stefaema/STEF/boards/transport/command_board/command_board.kicad_pcb

## KiCad design boards/transport/command_board/command_board.kicad_pcb (2026-08-15)

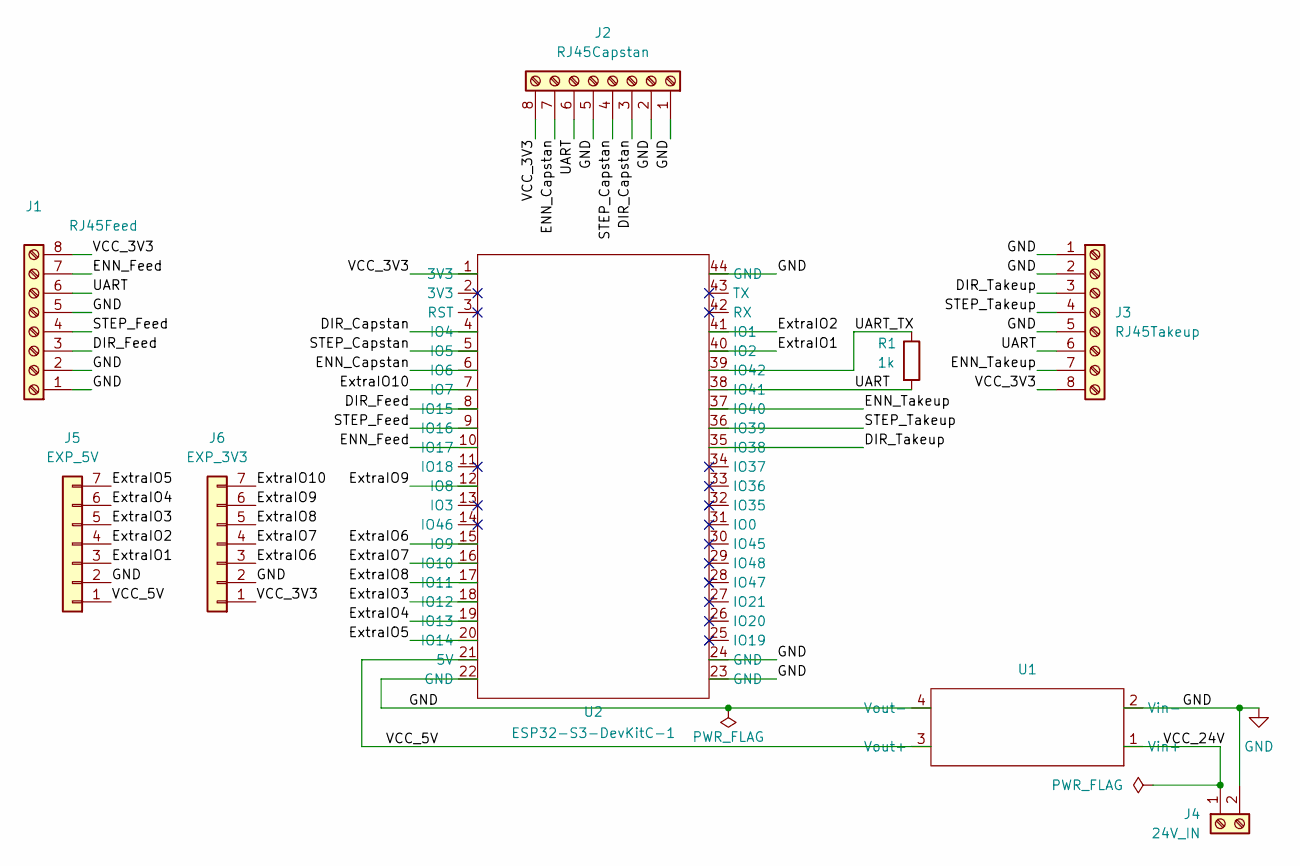
[picture p1: schematic command_board.kicad_sch, STEF Command Board]

Parts:
J1: RJ45Feed; PhoenixContact_MC_1,5_8-G-3.5_1x08_P3.50mm_Horizontal
J2: RJ45Capstan; PhoenixContact_MC_1,5_8-G-3.5_1x08_P3.50mm_Horizontal
J3: RJ45Takeup; PhoenixContact_MC_1,5_8-G-3.5_1x08_P3.50mm_Horizontal
J4: 24V_IN; TerminalBlock_RND_205-00287_1x02_P5.08mm_Horizontal
J5: EXP_5V; PinHeader_1x07_P2.54mm_Vertical
J6: EXP_3V3; PinHeader_1x07_P2.54mm_Vertical
R1: 1k; R_Axial_DIN0207_L6.3mm_D2.5mm_P10.16mm_Horizontal
U1: Buck_LM2596; Buck_LM2596_Socketed_2x02
U2: ESP32-S3-DevKitC-1; ESP32-S3-DevKitC-1_Socketed_2x22

Connections:
/DIR_Capstan: J2.3, U2.4 (IO4)
/DIR_Feed: J1.3, U2.8 (IO15)
/DIR_Takeup: J3.3, U2.35 (IO38)
/ENN_Capstan: J2.7, U2.6 (IO6)
/ENN_Feed: J1.7, U2.10 (IO17)
/ENN_Takeup: J3.7, U2.37 (IO40)
/ExtraIO1: J5.3, U2.40 (IO2)
/ExtraIO2: J5.4, U2.41 (IO1)
/ExtraIO3: J5.5, U2.18 (IO12)
/ExtraIO4: J5.6, U2.19 (IO13)
/ExtraIO5: J5.7, U2.20 (IO14)
/ExtraIO6: J6.3, U2.15 (IO9)
/ExtraIO7: J6.4, U2.16 (IO10)
/ExtraIO8: J6.5, U2.17 (IO11)
/ExtraIO9: J6.6, U2.12 (IO8)
/ExtraIO10: J6.7, U2.7 (IO7)
/STEP_Capstan: J2.4, U2.5 (IO5)
/STEP_Feed: J1.4, U2.9 (IO16)
/STEP_Takeup: J3.4, U2.36 (IO39)
/UART: J1.6, J2.6, J3.6, R1.2, U2.38 (IO41)
/UART_TX: R1.1, U2.39 (IO42)
/VCC_3V3: J1.8, J2.8, J3.8, J6.1, U2.1 (3V3)
/VCC_5V: J5.1, U1.3 (Vout+), U2.21 (5V)
/VCC_24V: J4.1, U1.1 (Vin+)
GND: J1.1, J1.2, J1.5, J2.1, J2.2, J2.5, J3.1, J3.2, J3.5, J4.2, J5.2, J6.2, U1.2 (Vin-), U1.4 (Vout-), U2.22 (GND), U2.23 (GND), U2.24 (GND), U2.44 (GND)

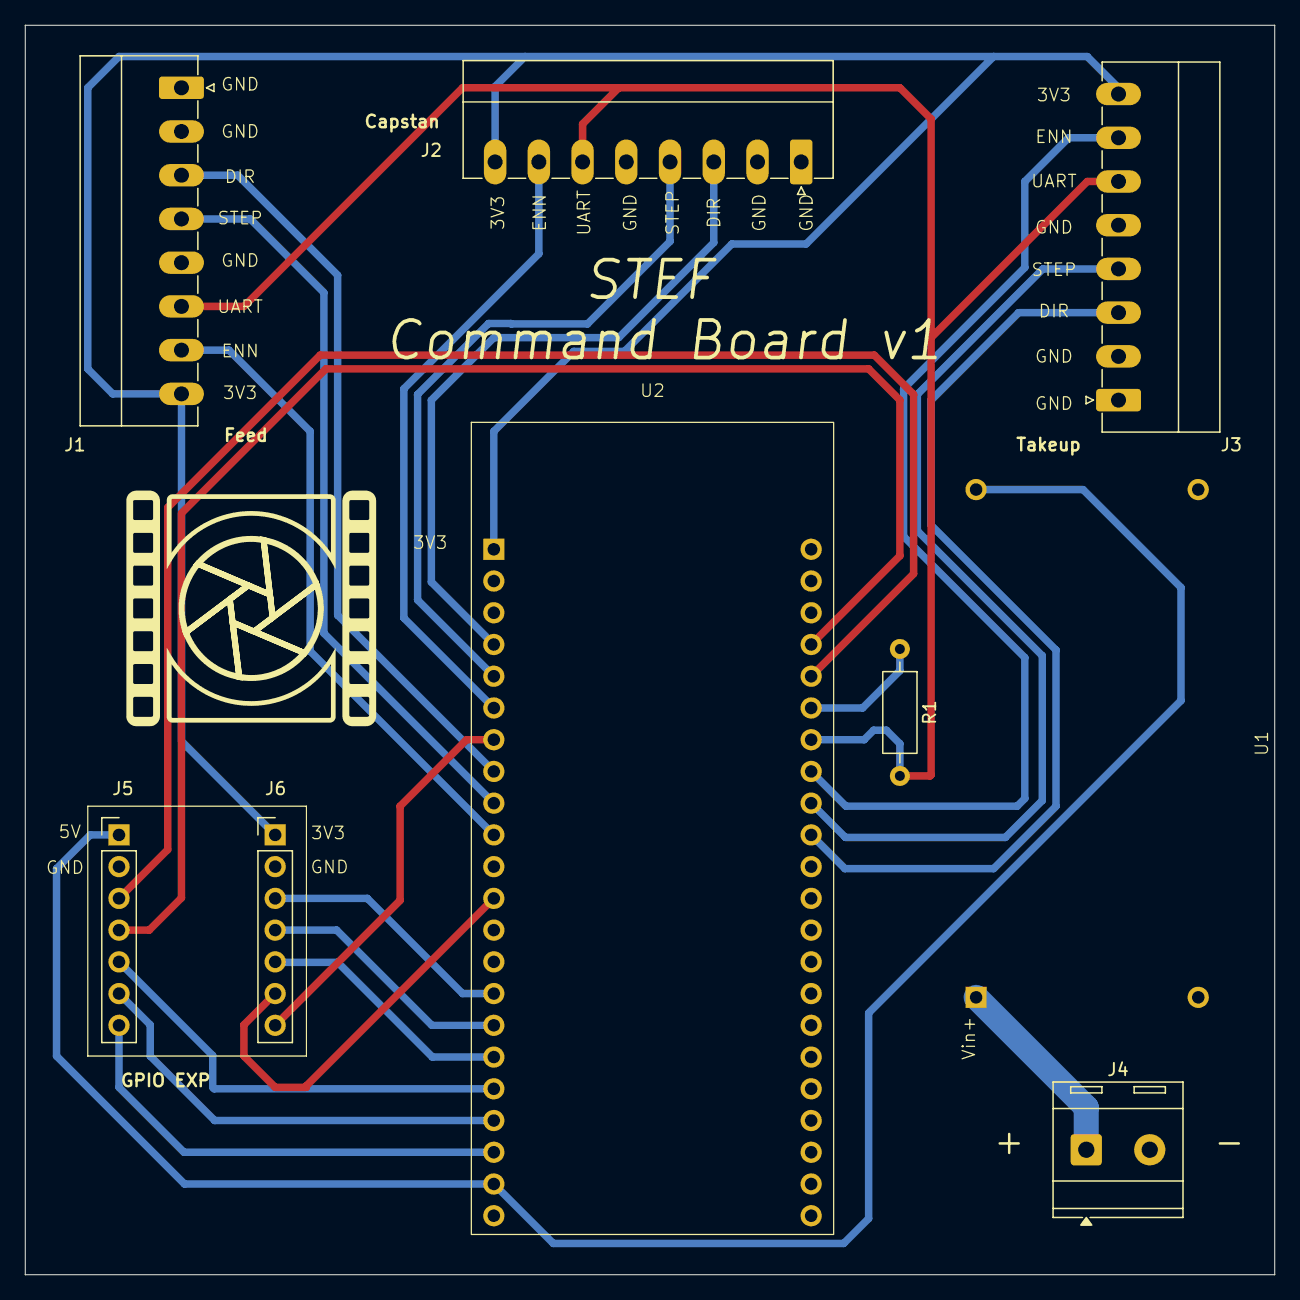
[picture p2: board command_board.kicad_pcb from above]

Board: 2 copper layers, 100.0 x 100.0 mm, 9 parts (0 on the bottom side), 25 nets.
