stefaema/STEF/boards/transport/drive_board/drive_board.kicad_pcb

## KiCad design boards/transport/drive_board/drive_board.kicad_pcb (2026-08-15)

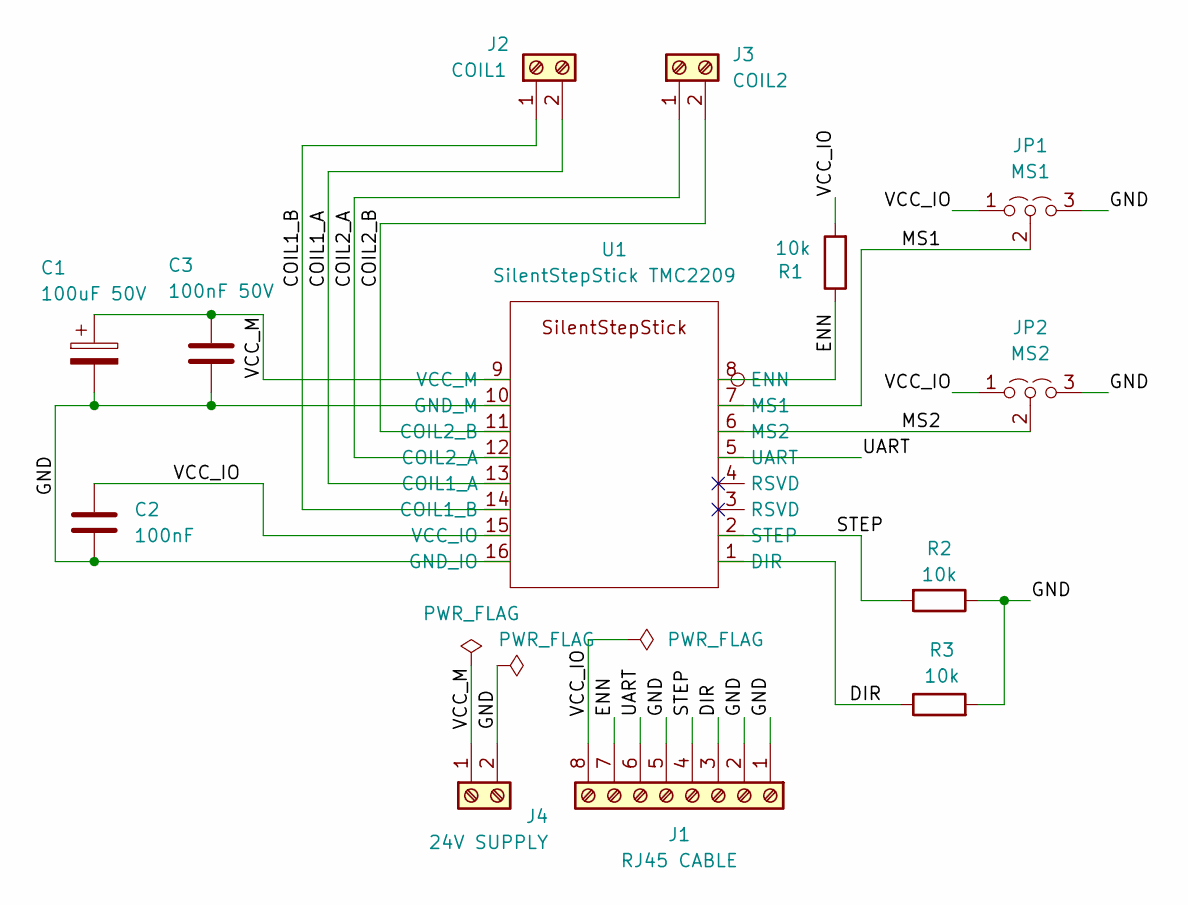
[picture p3: schematic drive_board.kicad_sch, STEF Drive Board]

Parts:
C1: 100uF 50V; CP_Radial_D8.0mm_P5.00mm
C2: 100nF; C_Disc_D7.0mm_W2.5mm_P5.00mm
C3: 100nF 50V; C_Disc_D7.0mm_W2.5mm_P5.00mm
J1: RJ45 CABLE; PhoenixContact_MC_1,5_8-G-3.5_1x08_P3.50mm_Horizontal
J2: COIL1; TerminalBlock_RND_205-00287_1x02_P5.08mm_Horizontal
J3: COIL2; TerminalBlock_RND_205-00287_1x02_P5.08mm_Horizontal
J4: 24V SUPPLY; TerminalBlock_RND_205-00287_1x02_P5.08mm_Horizontal
JP1: MS1; PinHeader_1x03_P2.54mm_Vertical
JP2: MS2; PinHeader_1x03_P2.54mm_Vertical
R1, R2, R3: 10k; R_Axial_DIN0207_L6.3mm_D2.5mm_P10.16mm_Horizontal
U1: SilentStepStick TMC2209; SilentStepStick_Socketed_2x08

Connections:
/COIL1_A: J2.2, U1.13 (COIL1_A)
/COIL1_B: J2.1, U1.14 (COIL1_B)
/COIL2_A: J3.1, U1.12 (COIL2_A)
/COIL2_B: J3.2, U1.11 (COIL2_B)
/DIR: J1.3, R3.1, U1.1 (DIR)
/ENN: J1.7, R1.1, U1.8 (ENN)
/GND: C1.2, C2.2, C3.2, J1.1, J1.2, J1.5, J4.2, JP1.3 (B), JP2.3 (B), R2.1, R3.2, U1.10 (GND_M), U1.16 (GND_IO); also elsewhere on the board
/MS1: JP1.2 (C), U1.7 (MS1); also elsewhere on the board
/MS2: JP2.2 (C), U1.6 (MS2)
/STEP: J1.4, R2.2, U1.2 (STEP)
/UART: J1.6, U1.5 (UART)
/VCC_IO: C2.1, J1.8, JP1.1 (A), JP2.1 (A), R1.2, U1.15 (VCC_IO); also elsewhere on the board
/VCC_M: C1.1, C3.1, J4.1, U1.9 (VCC_M)

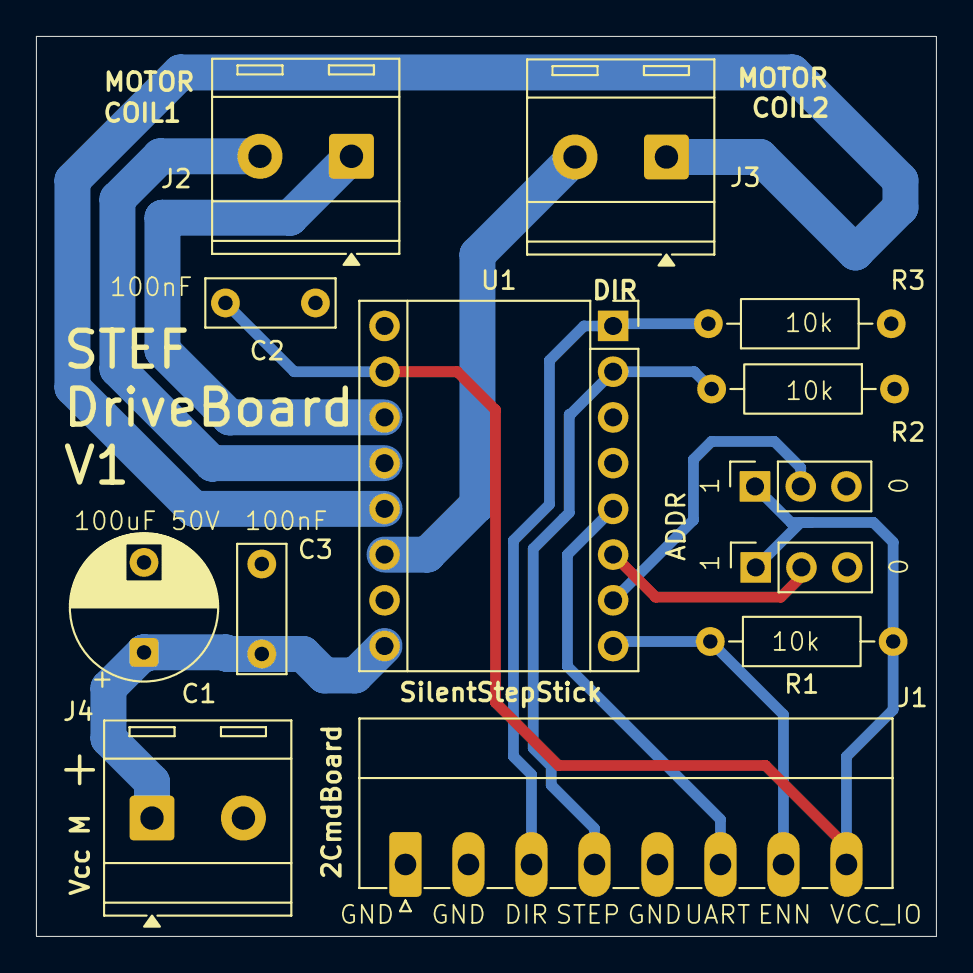
[picture p4: board drive_board.kicad_pcb from above]

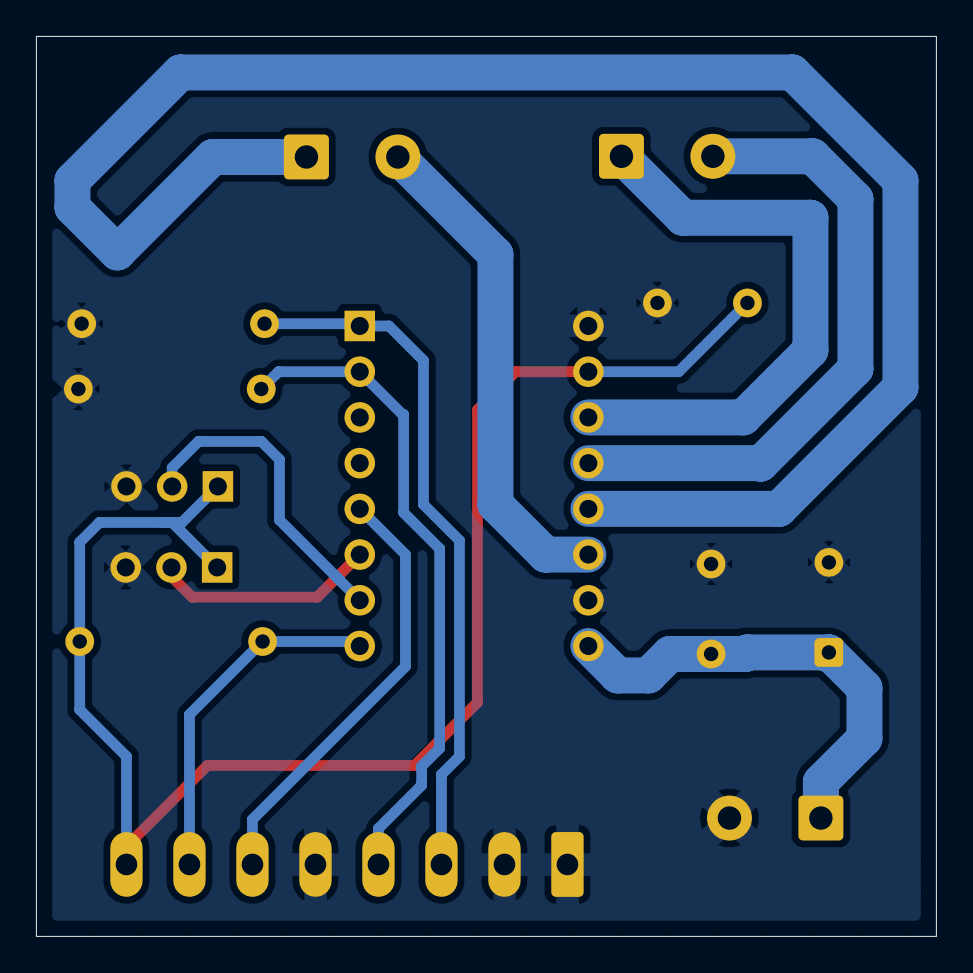
[picture p5: board drive_board.kicad_pcb from below]

Board: 2 copper layers, 50.0 x 50.0 mm, 13 parts (8 on the bottom side), 13 nets.

Other parts of the board:
ADDR: MS1; PinHeader_1x03_P2.54mm_Vertical

Their connections:
/GND: ADDR.3 (B); also elsewhere on the board
/MS1: ADDR.2 (C); also elsewhere on the board
/VCC_IO: ADDR.1 (A); also elsewhere on the board
