stefaema/STEF/portable/tmc2209/test/test_lines.c

/*
 * test_lines.c: the control lines, against a fake board.
 *
 * The theme is that a line call either does exactly what it says or refuses.
 * There is no third outcome where some other pin moves, which is what the
 * wiring mask exists to prevent: a board that does not connect DIAG must be
 * told apart from a board that connects it and reads low.
 *
 * Polarity is the other half. ENN is active low, so enable() and the raw level
 * disagree by construction, and a test that only ever asked one of them could
 * not tell a correct implementation from an inverted one.
 */

#include "tmc2209.h"
#include "unity.h"

#include <string.h>

/* A board with four pins. Levels persist, so a write is observable by the
   read that follows it, the way a real output reads back what it drives. */
typedef struct {
    bool     level[TMC2209_LINE_COUNT];
    unsigned writes[TMC2209_LINE_COUNT];
    unsigned reads[TMC2209_LINE_COUNT];
    int      fail_read;    /* backend failure, until cleared */
    int      fail_write;
} fake_board_t;

static fake_board_t    g_board;
static tmc2209_lines_t g_lines;
static tmc2209_t       g_dev;

static int board_read(void *ctx, tmc2209_line_t line)
{
    fake_board_t *b = (fake_board_t *)ctx;
    b->reads[line]++;
    if (b->fail_read) {
        return -1;
    }
    return (int)b->level[line];
}

static int board_write(void *ctx, tmc2209_line_t line, bool level)
{
    fake_board_t *b = (fake_board_t *)ctx;
    b->writes[line]++;
    if (b->fail_write) {
        return -1;
    }
    b->level[line] = level;
    return 0;
}

/* No bus is attached anywhere in this file. Lines and bytes are independent
   backends, and the whole suite runs without a port to prove it.

   @p wired is what this board connects, so a test can build a board missing a
   line and assert the refusal. */
static void setup_board(uint8_t wired)
{
    memset(&g_board, 0, sizeof g_board);

    g_lines.read  = board_read;
    g_lines.write = board_write;
    g_lines.ctx   = &g_board;
    g_lines.wired = wired;

    TEST_ASSERT_EQUAL(TMC2209_OK, tmc2209_init(&g_dev, 0));
    TEST_ASSERT_EQUAL(TMC2209_OK, tmc2209_attach_lines(&g_dev, &g_lines));
}

static bool line_level(tmc2209_line_t line)
{
    bool level = false;
    TEST_ASSERT_EQUAL(TMC2209_OK, tmc2209_line_read(&g_dev, line, &level));
    return level;
}

/* ── Attachment ─────────────────────────────────────────────────────────── */

/* A configuration-only caller attaches nothing, and must not need a stub
   backend to compile or to get a sensible answer. */
static void test_a_device_without_lines_refuses_every_line_call(void)
{
    setup_board(TMC2209_LINES_ALL);
    TEST_ASSERT_EQUAL(TMC2209_OK, tmc2209_attach_lines(&g_dev, NULL));

    bool level = false;
    TEST_ASSERT_EQUAL(TMC2209_ERR_NO_BACKEND, tmc2209_line_read(&g_dev, TMC2209_LINE_DIAG, &level));
    TEST_ASSERT_EQUAL(TMC2209_ERR_NO_BACKEND, tmc2209_line_write(&g_dev, TMC2209_LINE_ENN, true));
    TEST_ASSERT_EQUAL(TMC2209_ERR_NO_BACKEND, tmc2209_enable(&g_dev, true));
    TEST_ASSERT_FALSE(tmc2209_line_is_wired(&g_dev, TMC2209_LINE_ENN));
}

static void test_init_leaves_lines_detached(void)
{
    setup_board(TMC2209_LINES_ALL);
    TEST_ASSERT_EQUAL(TMC2209_OK, tmc2209_init(&g_dev, 0));

    TEST_ASSERT_EQUAL(TMC2209_ERR_NO_BACKEND, tmc2209_enable(&g_dev, true));
    TEST_ASSERT_EQUAL(0U, g_board.writes[TMC2209_LINE_ENN]);
}

/* The two refusals carry different instructions: attach a backend, or accept
   that the pin is not on this board. One code for both would leave a bring-up
   routine unable to tell a setup mistake from the wiring it was handed. */
static void test_a_missing_backend_reads_apart_from_a_missing_pin(void)
{
    setup_board(TMC2209_LINES_ALL & (uint8_t)~TMC2209_LINE_BIT(TMC2209_LINE_DIAG));
    TEST_ASSERT_EQUAL(TMC2209_ERR_UNWIRED, tmc2209_line_write(&g_dev, TMC2209_LINE_DIAG, true));

    TEST_ASSERT_EQUAL(TMC2209_OK, tmc2209_attach_lines(&g_dev, NULL));
    TEST_ASSERT_EQUAL(TMC2209_ERR_NO_BACKEND, tmc2209_line_write(&g_dev, TMC2209_LINE_DIAG, true));
}

/* A line outside the enum is a bad argument whatever is attached, so the
   argument check has to come first. */
static void test_a_bad_line_outranks_a_missing_backend(void)
{
    setup_board(TMC2209_LINES_ALL);
    TEST_ASSERT_EQUAL(TMC2209_OK, tmc2209_attach_lines(&g_dev, NULL));

    TEST_ASSERT_EQUAL(TMC2209_ERR_ARG, tmc2209_line_write(&g_dev, TMC2209_LINE_COUNT, true));
}

/* Half a backend is not a backend: accepting one would defer the crash to the
   first call rather than reject it at the seam. */
static void test_attach_rejects_an_incomplete_backend(void)
{
    setup_board(TMC2209_LINES_ALL);

    tmc2209_lines_t half = g_lines;
    half.write           = NULL;
    TEST_ASSERT_EQUAL(TMC2209_ERR_ARG, tmc2209_attach_lines(&g_dev, &half));

    half      = g_lines;
    half.read = NULL;
    TEST_ASSERT_EQUAL(TMC2209_ERR_ARG, tmc2209_attach_lines(&g_dev, &half));
}

/* ── Raw levels ─────────────────────────────────────────────────────────── */

static void test_a_written_level_reads_back(void)
{
    setup_board(TMC2209_LINES_ALL);

    TEST_ASSERT_EQUAL(TMC2209_OK, tmc2209_line_write(&g_dev, TMC2209_LINE_DIR, true));
    TEST_ASSERT_TRUE(line_level(TMC2209_LINE_DIR));

    TEST_ASSERT_EQUAL(TMC2209_OK, tmc2209_line_write(&g_dev, TMC2209_LINE_DIR, false));
    TEST_ASSERT_FALSE(line_level(TMC2209_LINE_DIR));
}

/* The reason the raw tier exists at all: no polarity, no interpretation. */
static void test_a_raw_write_applies_no_polarity(void)
{
    setup_board(TMC2209_LINES_ALL);

    TEST_ASSERT_EQUAL(TMC2209_OK, tmc2209_line_write(&g_dev, TMC2209_LINE_ENN, true));
    TEST_ASSERT_TRUE(g_board.level[TMC2209_LINE_ENN]);
}

static void test_each_line_moves_only_its_own_pin(void)
{
    setup_board(TMC2209_LINES_ALL);

    TEST_ASSERT_EQUAL(TMC2209_OK, tmc2209_line_write(&g_dev, TMC2209_LINE_STEP, true));

    TEST_ASSERT_EQUAL(1U, g_board.writes[TMC2209_LINE_STEP]);
    TEST_ASSERT_EQUAL(0U, g_board.writes[TMC2209_LINE_ENN]);
    TEST_ASSERT_EQUAL(0U, g_board.writes[TMC2209_LINE_DIR]);
    TEST_ASSERT_EQUAL(0U, g_board.writes[TMC2209_LINE_DIAG]);
}

static void test_diag_reads(void)
{
    setup_board(TMC2209_LINES_ALL);

    g_board.level[TMC2209_LINE_DIAG] = true;
    TEST_ASSERT_TRUE(line_level(TMC2209_LINE_DIAG));
}

/* Driving an input is a caller error and not a board fact, so it survives a
   board that wires everything. */
static void test_driving_an_input_is_refused(void)
{
    setup_board(TMC2209_LINES_ALL);

    TEST_ASSERT_EQUAL(TMC2209_ERR_ACCESS, tmc2209_line_write(&g_dev, TMC2209_LINE_DIAG, true));
    TEST_ASSERT_EQUAL(0U, g_board.writes[TMC2209_LINE_DIAG]);
}

/* An unwired line is refused before the access policy is consulted: this board
   never connected DIAG, which is the more specific truth about it. */
static void test_an_unwired_line_is_reported_as_unwired(void)
{
    setup_board(TMC2209_LINES_ALL & (uint8_t)~TMC2209_LINE_BIT(TMC2209_LINE_DIAG));

    bool level = false;
    TEST_ASSERT_FALSE(tmc2209_line_is_wired(&g_dev, TMC2209_LINE_DIAG));
    TEST_ASSERT_EQUAL(TMC2209_ERR_UNWIRED, tmc2209_line_read(&g_dev, TMC2209_LINE_DIAG, &level));
    TEST_ASSERT_EQUAL(TMC2209_ERR_UNWIRED, tmc2209_line_write(&g_dev, TMC2209_LINE_DIAG, true));
    TEST_ASSERT_EQUAL(0U, g_board.reads[TMC2209_LINE_DIAG]);
}

/* Missing one line leaves the rest usable, so the mask is per line and not a
   switch on the whole backend. */
static void test_the_lines_a_board_does_wire_still_work(void)
{
    setup_board(TMC2209_LINES_ALL & (uint8_t)~TMC2209_LINE_BIT(TMC2209_LINE_DIAG));

    TEST_ASSERT_EQUAL(TMC2209_OK, tmc2209_enable(&g_dev, true));
    TEST_ASSERT_TRUE(tmc2209_line_is_wired(&g_dev, TMC2209_LINE_STEP));
}

static void test_a_line_outside_the_enum_is_a_bad_argument(void)
{
    setup_board(TMC2209_LINES_ALL);

    bool level = false;
    TEST_ASSERT_EQUAL(TMC2209_ERR_ARG, tmc2209_line_read(&g_dev, TMC2209_LINE_COUNT, &level));
    TEST_ASSERT_EQUAL(TMC2209_ERR_ARG, tmc2209_line_write(&g_dev, TMC2209_LINE_COUNT, true));
    TEST_ASSERT_EQUAL(TMC2209_ERR_ARG, tmc2209_line_read(&g_dev, TMC2209_LINE_ENN, NULL));
}

/* A backend failure is neither a level nor a refusal, and the caller's
   variable must not be left holding an invented one. */
static void test_a_backend_failure_yields_no_level(void)
{
    setup_board(TMC2209_LINES_ALL);
    g_board.fail_read = 1;

    bool level = true;
    TEST_ASSERT_EQUAL(TMC2209_ERR_IO, tmc2209_line_read(&g_dev, TMC2209_LINE_DIAG, &level));
    TEST_ASSERT_TRUE(level);

    g_board.fail_read  = 0;
    g_board.fail_write = 1;
    TEST_ASSERT_EQUAL(TMC2209_ERR_IO, tmc2209_line_write(&g_dev, TMC2209_LINE_DIR, true));
    TEST_ASSERT_EQUAL(TMC2209_ERR_IO, tmc2209_enable(&g_dev, true));
}

/* ── Enable ─────────────────────────────────────────────────────────────── */

/* The one place polarity is applied. Enabled is ENN low, and asserting the
   level rather than the round trip is what catches an inverted implementation
   that is self-consistent. */
static void test_enable_drives_enn_low(void)
{
    setup_board(TMC2209_LINES_ALL);

    TEST_ASSERT_EQUAL(TMC2209_OK, tmc2209_enable(&g_dev, true));
    TEST_ASSERT_FALSE(g_board.level[TMC2209_LINE_ENN]);

    TEST_ASSERT_EQUAL(TMC2209_OK, tmc2209_enable(&g_dev, false));
    TEST_ASSERT_TRUE(g_board.level[TMC2209_LINE_ENN]);
}

static void test_is_enabled_inverts_the_level_back(void)
{
    setup_board(TMC2209_LINES_ALL);

    bool on                         = false;
    g_board.level[TMC2209_LINE_ENN] = false;
    TEST_ASSERT_EQUAL(TMC2209_OK, tmc2209_is_enabled(&g_dev, &on));
    TEST_ASSERT_TRUE(on);

    g_board.level[TMC2209_LINE_ENN] = true;
    TEST_ASSERT_EQUAL(TMC2209_OK, tmc2209_is_enabled(&g_dev, &on));
    TEST_ASSERT_FALSE(on);
}

/* Enable is a pin and nothing else. A driver whose configuration would make it
   hold no current still enables, because refusing here would hide a condition
   the caller is better off polling for. */
static void test_enable_touches_no_register(void)
{
    setup_board(TMC2209_LINES_ALL);

    TEST_ASSERT_EQUAL(TMC2209_OK, tmc2209_enable(&g_dev, true));
    TEST_ASSERT_EQUAL(0U, g_dev.valid);
    TEST_ASSERT_EQUAL(1U, g_board.writes[TMC2209_LINE_ENN]);
}

void run_lines_tests(void)
{
    RUN_TEST(test_a_device_without_lines_refuses_every_line_call);
    RUN_TEST(test_init_leaves_lines_detached);
    RUN_TEST(test_attach_rejects_an_incomplete_backend);
    RUN_TEST(test_a_missing_backend_reads_apart_from_a_missing_pin);
    RUN_TEST(test_a_bad_line_outranks_a_missing_backend);

    RUN_TEST(test_a_written_level_reads_back);
    RUN_TEST(test_a_raw_write_applies_no_polarity);
    RUN_TEST(test_each_line_moves_only_its_own_pin);
    RUN_TEST(test_diag_reads);
    RUN_TEST(test_driving_an_input_is_refused);
    RUN_TEST(test_an_unwired_line_is_reported_as_unwired);
    RUN_TEST(test_the_lines_a_board_does_wire_still_work);
    RUN_TEST(test_a_line_outside_the_enum_is_a_bad_argument);
    RUN_TEST(test_a_backend_failure_yields_no_level);

    RUN_TEST(test_enable_drives_enn_low);
    RUN_TEST(test_is_enabled_inverts_the_level_back);
    RUN_TEST(test_enable_touches_no_register);
}
