stefaema/STEF/(commit log)

2026-07-25 firmware: First Approach to ESP32
2026-07-26 firmware: Refactor unit tests for TMC2209 register classification and access
    - Updated comments for clarity and accuracy in test_frame.c and test_reg.c.
    - Introduced new helper function to count register classes.
    - Enhanced tests to ensure every register is classified correctly.
    - Added tests for volatile, owned, and constant registers to verify access rights.
    - Improved readability and structure of existing tests, ensuring they align with the updated classification logic.
    - Removed redundant tests and consolidated functionality to streamline the testing process.
    [mock_tmc2209.c, mock_tmc2209.h, test_device.c, test_frame.c, test_reg.c, tmc2209.c, tmc2209.h, tmc2209_frame.c]
2026-07-26 firmware: Refactor TMC2209 error handling and improve documentation
    - Renamed error code TMC2209_ERR_STALE to TMC2209_ERR_INVALID_SLOT for clarity.
    - Updated comments throughout the TMC2209 driver to reflect that access permissions are determined by the driver, not the silicon.
    - Modified unit tests to use the new error code and updated assertions to reflect changes in ownership validation.
    - Enhanced test descriptions for clarity and consistency, particularly regarding driver behavior and register access.
    - Ensured that all references to silicon behavior are replaced with driver behavior for accuracy in documentation and testing.
    [mock_tmc2209.c, mock_tmc2209.h, test_device.c, test_frame.c, test_reg.c, tmc2209.c, tmc2209.h, tmc2209_frame.c]
2026-07-26 firmware: Fix casing for constants in TMC2209 frame functions
    [tmc2209_frame.c]
2026-07-26 firmware: give error types its own file
    [tmc2209.h, tmc2209_err.c, tmc2209_err.h, tmc2209_frame.c, tmc2209_frame.h, tmc2209_reg.h]
2026-07-26 firmware: Refactor TMC2209 frame functions to use defined constants for address and write flag
2026-07-26 firmware: driver wsas firmware, duplicated out
2026-07-27 firmware: Refactor TMC2209 driver communication and error handling
    - Updated function names and documentation for clarity, changing `tmc2209_bus_xfer` to `tmc2209_bus_send` to better reflect its purpose.
    - Enhanced error handling by distinguishing between transmit and receive timeouts with new error codes: `TMC2209_ERR_TX_TIMEOUT` and `TMC2209_ERR_RX_TIMEOUT`.
    - Improved the handling of replies in the passthrough mode, ensuring that the number of bytes received is reported accurately, even in cases of echo mismatches or truncated replies.
    - Added new tests to validate the behavior of the passthrough functionality, including scenarios for silence, partial replies, and echo mismatches.
    - Docum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
    [mock_tmc2209.c, mock_tmc2209.h, test_device.c, test_frame.c, test_reg.c, tmc2209.c, tmc2209.h, tmc2209_err.c]
2026-07-28 firmware: Refactor TMC2209 driver API: rename adopt() to bringup() and update related documentation
2026-07-28 firmware: Add error handling for unread pulse counts in TMC2209 driver
    - Introduced TMC2209_ERR_UNREAD to indicate when the last run's pulse count was not collected before starting a new run.
    - Updated error handling in tmc2209_move() to return TMC2209_ERR_UNREAD if a new move is attempted without collecting the previous count.
    - Modified tmc2209_poll_motion() to reflect the new error handling and ensure the emitted pulse count is correctly reported.
    - Adjusted the RPC interface to accommodate changes in the move structure, including direction and shaft bit handling.
    - Updated unit tests to verify the new behavior regarding unread counts and ensure proper error handling in various scenarios.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
    [rpc_proto.h, rpc_raw.c, rpc_status.c, test_rpc.c, test_stepgen.c, tmc2209.h, tmc2209_err.c, tmc2209_err.h]
2026-07-28 firmware: Rename polling functions for clarity: replace `tmc2209_poll_motion` with `tmc2209_get_motion_report` across documentation, implementation, and tests.
    [rpc_raw.c, test_stepgen.c, tmc2209.h, tmc2209_stepgen.c]
2026-07-28 firmware: Refactor RPC Protocol Definitions and Separate API
    - Introduced a new header file `rpc_api.h` to define namespaces, method numbers, and statuses, separating concerns from the transport layer.
    - Updated `rpc_proto.h` to focus solely on frame structure and transport properties.
    - Adjusted the maximum number of namespaces from `RPC_NS_COUNT` to `RPC_NS_MAX` across relevant files.
    - Modified RPC registration and dispatch functions to utilize the new maximum namespace definition.
    - Updated all relevant source files to include `rpc_api.h` instead of `rpc_proto.h` where appropriate.
    - Revised unit tests to decouple from specific method and namespace definitions, using generic placeholders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
2026-07-29 firmware: Enhance comments for clarity in TMC2209 frame functions and improve error handling
    [tmc2209_frame.c, tmc2209_frame.h]
2026-07-29 firmware: Refactor error handling in TMC2209 component: rename ERR_SYNC to ERR_PREAMBLE, update related documentation, and adjust tests accordingly. Add TMC2209.PDF documentation file.
    [rpc_status.c, test_frame.c, tmc2209_err.c, tmc2209_err.h, tmc2209_frame.c, tmc2209_lines.h]
2026-07-29 firmware: Refactor TMC2209 component regarding lines: reorganize includes, enhance error handling for line access, and update related tests for consistency.
    [test_stepgen.c, tmc2209.h, tmc2209_lines.c, tmc2209_stepgen.c]
2026-07-29 firmware: Refactor TMC2209 driver to use UART interface
    - Introduced a new private header file `tmc2209_uart_priv.h` to manage UART-specific operations.
    - Updated backend initialization to use `tmc2209_uart_t` instead of `tmc2209_port_t`.
    - Renamed functions and variables to reflect the transition from port to UART, including changes in `backends.c`, `backends.h`, `devices.c`, and `rpc_passthrough.c`.
    - Modified unit tests to accommodate the new UART interface, ensuring all references to bus operations are replaced with UART operations.
    - Ensured that mock functions and test setups are updated to reflect the new UART structure.
    - Updated documentation comments to clarify the changes from por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
    [backends.c, backends.h, devices.c, mock_tmc2209.c, mock_tmc2209.h, rpc_passthrough.c, rpc_sys.c, test_device.c]
2026-07-29 firmware: Refactor TMC2209 movement and reporting structures
    - Renamed `tmc2209_move_t` to `tmc2209_movement_plan_t` for clarity.
    - Renamed `tmc2209_motion_t` to `tmc2209_motion_report_t` to better reflect its purpose.
    - Updated function signatures and variable types across the codebase to use the new names.
    - Removed unused `RPC_UNREAD` status and related error handling.
    - Adjusted mock initialization to use a defined reset value for IOIN.
    - Enhanced unit tests to reflect the new naming conventions and ensure proper functionality.
    - Improved comments for clarity and understanding of the code logic.
    [crc16.h, mock_tmc2209.c, mock_tmc2209.h, rpc_api.h, rpc_proto.h, rpc_raw.c, rpc_status.c, test_device.c]
2026-07-29 firmware: Fix formatting inconsistencies in COBS and CRC16 implementations
    [cobs.c, cobs.h, crc16.c, crc16.h]
2026-07-29 firmware: Remove rpc_wire.h and rpc_wire.c implementations; add comprehensive tests for wire format in test_rpc_frame.c
2026-07-29 firmware: Implement RPC frame handling with headers and CRC
    - Introduced `rpc_frame.h` and `rpc_frame.c` to manage the framing of RPC messages.
    - Added functions to seal request, reply, and log frames, ensuring proper header and CRC handling.
    - Implemented validation for frame integrity, including CRC checks and type verification.
    - Updated unit tests in `test_rpc_frame.c` to cover new frame functionalities and ensure correct behavior.
    - Refactored existing tests to align with the new frame structure and naming conventions.
    [main.c, rpc_api.h, rpc_dispatch.c, rpc_dispatch.h, rpc_frame.c, rpc_frame.h, rpc_link.c, rpc_methods.h]
2026-07-30 firmware: Add TMC2209 driver support with RPC interface and watchdog functionality
    - Implemented RPC status mapping for TMC2209 errors in rpc_status.c and rpc_status.h.
    - Created rpc_sys.c to handle system-level RPC methods including version, state, and device information.
    - Developed backends for TMC2209 communication over UART in backends.c and backends.h.
    - Defined board configuration for TMC2209 drivers in board.c and board.h.
    - Initialized device management for TMC2209 drivers in devices.c and devices.h.
    - Introduced watchdog functionality to monitor and halt devices if communication fails in watchdog.c and watchdog.h.
    - Ensured compatibility with ESP-IDF and added necessary includes fo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
    [backends.c, backends.h, board.c, board.h, devices.c, devices.h, rpc_api.h, rpc_link.c]
2026-07-30 firmware: Enhance firmware documentation and structure
    - Updated README.md to provide detailed descriptions of the firmware components, toolchain setup, testing procedures, and flashing instructions.
    - Removed the self-test main file (selftest_main.c) as it is no longer needed.
    - Adjusted .clangd configuration for clarity and removed unnecessary comments.
    - Modified CMakeLists.txt to clean up comments and improve readability.
    - Updated unit tests in test_reg.c and test_stepgen.c to use uppercase for hexadecimal literals for consistency.
    - Added a new TEMP.c file containing self-test functionality for the WS2812 LED.
    - Improved find_esp32_port.py by simplifying comments related to known USB b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
    [test_reg.c, test_stepgen.c]
2026-07-30 boards: Add README files for Boards and CCAPI Client sections
2026-08-02 firmware: Refactor TMC2209 Documentation and Code Comments
    - Updated the documentation for the StallGuard load estimate function to clarify its validity context.
    - Removed unnecessary comments regarding reset values in the TMC2209 register information structure.
    - Enhanced comments for the TSTEP register to specify its measurement context.
    - Revised test comments for clarity and to remove references to design documentation sections.
    [test_device.c, tmc2209.h, tmc2209_reg.c]
2026-08-02 firmware: Refactor code for consistency and clarity
    - Updated various instances of numeric literals to use uppercase 'U' suffix for unsigned integers in test files.
    - Changed return statements in board_read functions to cast boolean values to int for clarity.
    - Improved comments and documentation in firmware report to enhance understanding of the driver and its communication protocols.
    - Adjusted terminology from "enlace serie" to "bus UART" for accuracy in the context of communication methods.
    - Ensured consistent formatting and style across multiple test files for better readability and maintainability.
2026-08-02 firmware: Add RPC console script, step generator backend, and clang-tidy configuration
    - Introduced `rpc_console.py`, an interactive console for testing the firmware's RPC link, allowing users to send commands and receive responses based on the protocol defined in `rpc_proto.h` and `rpc_api.h`.
    - Implemented a new step generator backend in `stepgen.c` for controlling stepper motors, utilizing RMT and pulse counter drivers for precise timing and control.
    - Added a `.clang-tidy` configuration file to enforce coding standards and improve code quality across the firmware project.
    - Refactored unit tests in `test_rpc.c` to enhance coverage for variable-length replies and ensure proper handling of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
2026-08-04 ci_cd: one module per concern, stages named lint test integration
    run.py parses arguments; the rest moved out. test runs lint and integration
    runs test, so the containment the names imply is real. Which stage a branch
    demands is BRANCH_STAGE now, not two shell hooks.
    clang-tidy could never parse the firmware without -D__XTENSA__, and saw only
    the firmware's compile database. Both fixed.
2026-08-04 transport: move the ESP32 port finder here as temp_esp32_finder
    Its docstring named the firmware devShell. This one has pyserial but no
    esptool, so the chip probe needs --port-only here.
2026-08-04 ci_cd: say "no tests found" once, and print only real failures
    sh() takes the exit codes a caller expects; check_test names pytest's 5.
2026-08-05 repo: ruff exclusions apply to the paths ci_cd names
    ci_cd passes explicit file paths from git ls-files, and ruff honours
    exclude and extend-exclude for a named path only when force-exclude is
    set. Every entry in the list was inert.
    Naming paths is not optional here: lint --staged selects by git state,
    which a directory walk cannot express.
    transport/fw_abi.py leaves the list. The generator formats it now, so it
    is checked like anything else.
2026-08-05 tmc2209: externally framed sends name tmc2209_uart_send
2026-08-05 repo: rename the passthrough namespace to relay
    The namespace and its methods now share one stem, so a binding can pair
    them. Wire value stays 1, so nothing renumbers.
    [rpc_api.h, rpc_methods.h, rpc_relay.c, test_rpc.c]
2026-08-05 transport: fw_link carries frames and pairs replies to requests
    Namespaces and methods are derived from the enums, not written. The
    reader owns the port; unmatched replies and bad frames are counted.
2026-08-05 transport: band the generator into its stages
2026-08-05 repo: docstrings and stage bands on the Python I added
    fw_abi_gen's stray constants move to the stage that uses them.
2026-08-06 transport: fw_api holds the surface, fw_link only moves bytes
    fw_api depends on fw_abi and nothing else: no stream, no threads, no
    framing. surface() returns the namespaces bound to any carrier, so the
    link no longer knows how the surface is assembled.
    [fw_api.py, fw_link.py]
2026-08-06 transport: fw_api relays the ABI, so callers import one module
    A module __getattr__ forwards anything fw_api does not define to fw_abi.
    surface() is now bind().
2026-08-06 transport: fw_link is four collaborators, not one class
    FrameReader reads, LogForwarder carries logs off the read path,
    RequestBroker keeps one request on the wire at a time so a timeout
    measures that call. fw_wire holds the codec and the splitter.
2026-08-08 fw_api: payloads cross the surface as Python, not as ctypes
    Every method's args and reply are a dataclass built from _fields_,
    SEMANTIC, FLEX and PY_ENUM. Padding and flex counts are gone, ctypes
    stays inside for packing, and fw_link needed no change.
    [api.py]
2026-08-08 repo: drop references to files that no longer exist
    firmware/docs/README.md and firmware/docs/dev/top-bottom-assessment.md
    were deleted in earlier refactors; flush() is named nowhere else in the
    tree.
    [fw_api.h, rpc_link.h, test_device.c]
2026-08-08 firmware: name the target, so a fresh checkout builds
    sdkconfig.defaults set no IDF_TARGET, so anything but an existing
    sdkconfig configured for esp32 and rpc_link failed to link against
    usb_serial_jtag. README already documented set-target as a manual step.
2026-08-08 repo: the prose beside a C call reaches the method that binds it
    abi_gen reads tmc2209.h for its comments alone and emits FUNCTION_DOC.
    Dataclass fields carry theirs in metadata["doc"]. raw.poll and raw.motion
    take their library call's name, so the correspondence resolves by name.
    [api.py, fw_api.h, rpc_raw.c, test_rpc.c, test_stepgen.c]
2026-08-10 tmc2209: a README for the device and its three channels
2026-08-10 transport: the bench flashes, probes and reads the board it names
2026-08-10 firmware: the console is UART0, and only an error rides the link
    [rpc_link.c]
2026-08-10 bench_api: a parameter is a dictionary, not a frozen record
    Six TypedDicts discriminated on kind, so a declaration is most of what a
    renderer reads and a misspelling fails at import. Every conversion a kind
    implies moves beside it, leaving wire.py as the JSON adapter. results owns how
    a step settled; an option whose label differs from its value is an Option.
    [app.py]
2026-08-11 transport: a device profile is the ten registers a bring-up writes
2026-08-12 transport: one module per stage, and the package owns its link
2026-08-12 gui: the backend reads routines, and wire.py only regroups them
2026-08-12 gui: the rail names the machine's two modes
2026-08-13 firmware: the board table is three drivers, declared in menuconfig
2026-08-13 transport: spin turns a shaft and reads the driver at every stage
2026-08-15 boards: the parts we socket are a library of our own
    KiCad ships no footprint for a module on female headers, so stef.pretty
    carries the SilentStepStick, the ESP32-S3 devkit and the LM2596 as 2x0N
    sockets. The flake pins the KiCad that opens them.
2026-08-15 boards: the drive board is one TMC2209 at the motor
    Each motor gets its own board: 24V and the two coils on screw terminals,
    MS1/MS2 jumpered to pick the UART address, and RJ45 back to the command
    board carrying the shared bus and that driver's step, dir and enable.
    [drive_board.kicad_pcb, drive_board.kicad_sch]
2026-08-15 boards: the command board is the ESP32-S3 and the 24V it steps down
    An LM2596 takes the 24V rail to 5V for the devkit, and three RJ45 jacks
    fan the UART bus and per-driver control out to capstan, feed and takeup.
    Screw terminals bring the supply in, headers expose 3V3 and 5V.
    [command_board.kicad_pcb, command_board.kicad_sch]
2026-08-15 firmware: the defaults are the pins the command board routes
    Capstan moves to 6/5/4, feed to 17/16/15, and driver 1 is called feed
    because that is the RJ45 it leaves by.
2026-08-18 rig: parts are python, so nix carries the build123d wheels
2026-08-18 rig: a side panel mount is a channel, its ribs and its cutout
2026-08-18 rig: the C14 inlet and the barrel jack are where power enters
2026-08-18 rig: build() and sample() are how a module offers a part
2026-08-19 repo: docs and comments say only what the code cannot
    Drops the dead WS2812 selftest Kconfig and main's unused esp_driver_rmt.
    UART trace now defaults off, and its help no longer claims the PC receives
    it: the hook logs at info, and only errors reach the link.
    [rpc_link.c, rpc_link.h, rpc_methods.h, rpc_raw.c, rpc_relay.c, rpc_status.c, rpc_status.h]
2026-08-19 firmware: rpc_link.h no longer claims errors bypass stdout
    log_to_link vprintfs every line and frames only the errors, so the console
    keeps them too. rpc_status.h loses its emptied comment body.
    [rpc_link.h, rpc_status.h]
2026-08-19 ccapi: a camera is an HTTP server, and this is the client
    Access is discovered from the manifest the camera publishes; volatility,
    which decides what may be remembered, is authored here. The API version
    is accepted rather than inferred, so firmware moving does not silently
    move every call. Blocks restore what they found; a held shutter does not.
2026-08-19 transport: the installed release is what a board ought to run
    Drops config_dir()/firmware.toml and pinned(). A pin naming a version only
    this machine has was a second source for what fw_api already settles, and
    nothing ever wrote it.
2026-08-19 logs: one line, one shape, one file, whatever said it
    A subsystem logs and does not know where it lands. The GUI stream is a sink
    rather than a second path, so one call site feeds both the file and the
    screen, and logs_to goes away. A firmware line is stamped when we received
    it and carries the board's own uptime, which a reset makes visible.
    [app.py, logs.py, runner.py, transport.py]
2026-08-19 capture: the camera is a subsystem the bench can drive
    Discovery answers what a port descriptor never could: the model, the serial,
    the exact URL, and whether CCAPI is switched on. So auto is a real answer and
    a configured address is the fallback, not the other way round.
    Every setting is declared twice by a loop, because a value control is only
    correct once the setting it belongs to is fixed.
    [link.py, probe.py]
2026-08-21 repo: one flake at the root, and a module declares what it needs
    A module hands back package lists rather than an assembled shell, because two
    python.withPackages on one PATH leave only one reachable, and the editor shell
    is the union of all of them. Every shell exports STEF_HOME, so logs land under
    local/ whichever one you entered.
2026-08-21 rig: bearing core, seat and idler roller
2026-08-21 logs: what a stdlib caller attached reaches the file too
2026-08-21 capture: browse hands back the path the camera gave
2026-08-21 ccapi: entering movie mode waits for the camera to be in it
2026-08-21 rig: a maker may return a family of parts
    Discovery names each variant after its module and exports samples under their
    own directory. The viewer lays every part on a grid, filters by name, and
    serves until stopped. The idler is the first family: round or square ring,
    either sign.
2026-08-22 subsystem: what the modules share and shouldn't belong to bench_api
    SubsystemState was declaring the bench as the layer every implementation
    depends on. Capture and transport now import only this, the port lists move
    to the bench modules that draw them, and probe answers with its own verdict.
2026-08-22 capture: fix discovery prelink routine
    [probe.py]
2026-08-22 repo: subsystem identity out of bench_api, into a machine
    A subsystem is a spec, a config, a bench and a state, assembled by machine/
    from what each api derives. The machine holds one focus, so an activity states
    what it refuses and every area gates on that.
2026-08-26 rig: parametrize wago mount channel width for 3-way cable
2026-08-26 rig: move red button cutout from extras to mounts
2026-08-26 film_formats: add is_negative and film material to the spec base
2026-08-26 rig: refactor how bearing mechanisms are declared
    - add RadialBearingSpec so a bearing's own dimensions are declared once and shared
    - let BearingCore cut a seat into one or both ends via BearingPlacement
    - rework BearingSeat's pocket to a revolved profile with named clearances instead of primitives
2026-08-26 rig: rewrite roller geometry around film_formats and gauges
    Rollers now build their profile from named regions (RollerPolarRegion,
    GaugeProfile) driven by FilmRollerGauge, instead of the old free-hand
    outline. OringSpec exists but isn't wired up anywhere yet: idler.py's
    gauges are all solid-track (contact=None), and film_roller.py doesn't
    read gauge.contact, so no groove gets cut for a real O-ring.
    The two-piece split reuses the same regions and now names its two
    halves female/male instead of body/cap. build_two_piece raises for
    single-gauge rollers: their split geometry currently collapses to a
    zero-height press fit.
